hdiessner/gardenirrigation/hardware/Schematics.pdf

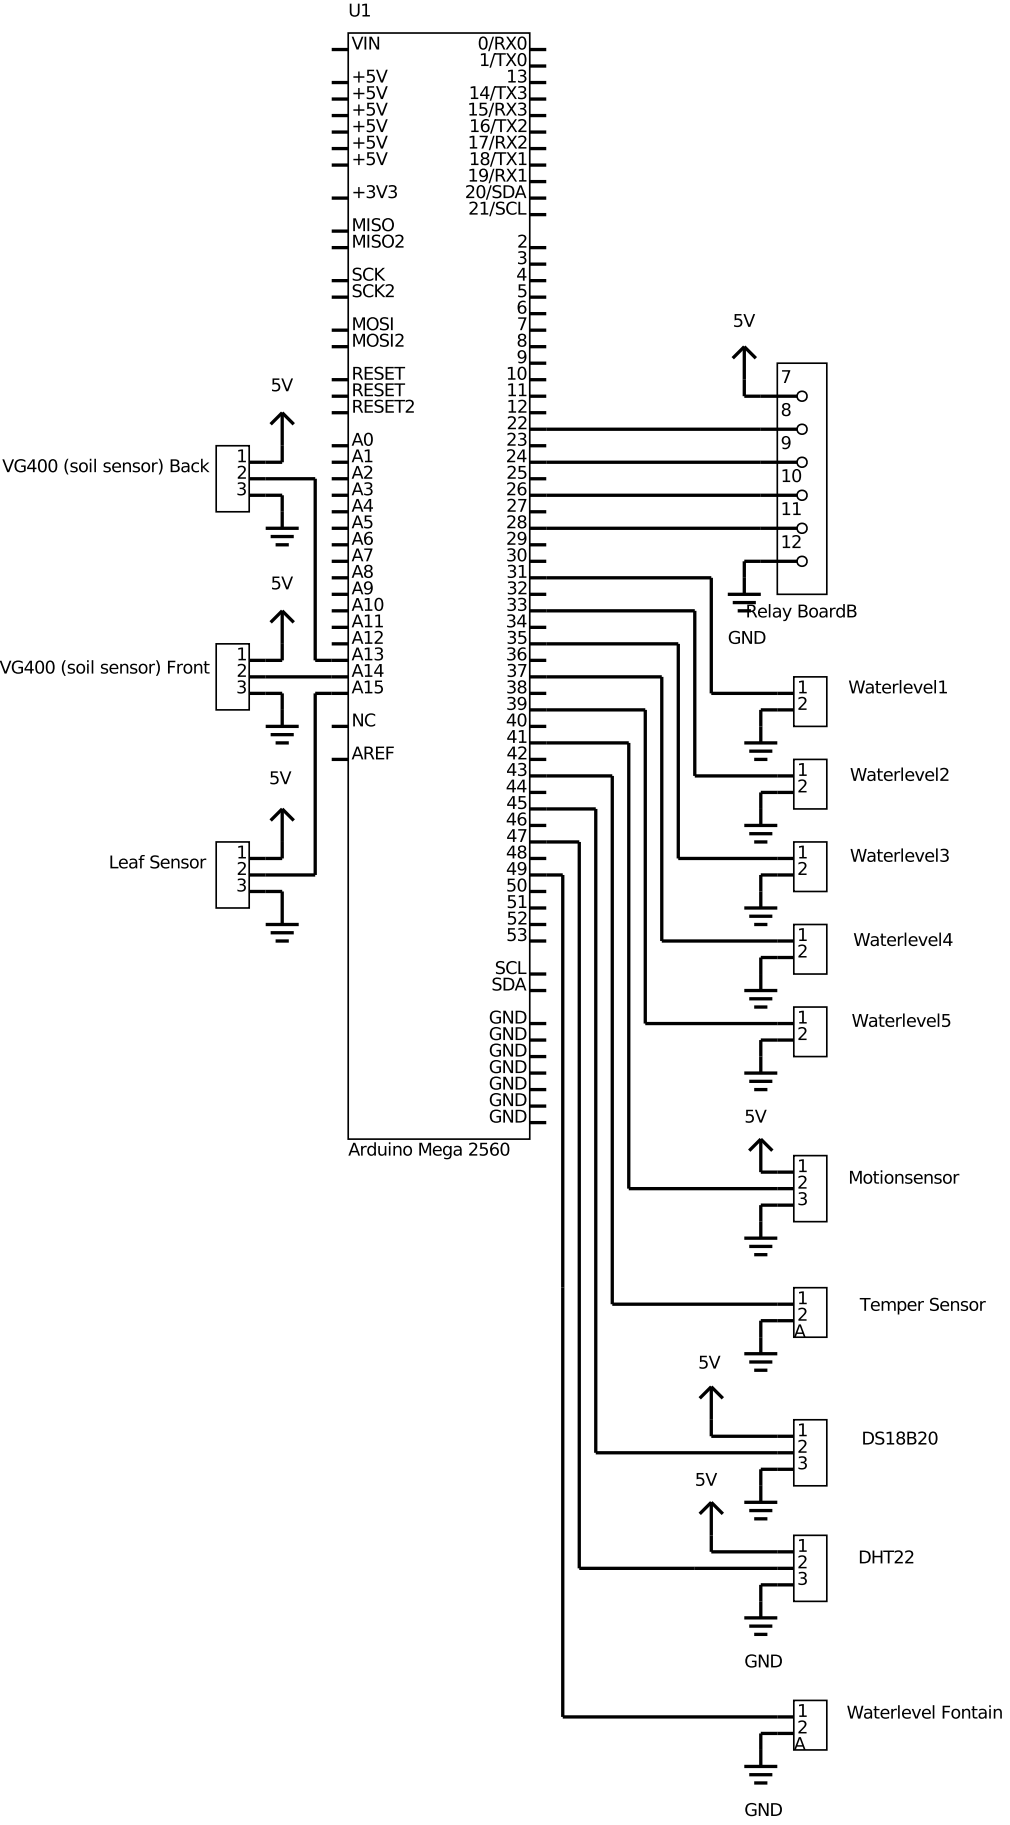
[picture p2: page 1]
