hdiessner/gardenirrigation/(commit log)

2018-06-27 Changed from arduino IDE to platoformio
2018-06-27 Adding Dallas Temperature sensor
2018-06-27 Adding Dallas temperatur sensor and clean up the code
2018-06-28 Sending now millis when motion event occures
2018-06-28 Adding schematics
2018-06-28 Schematics in documentation
2018-06-28 Added documentation for DHT wires
2018-06-30 Adding wire description
2018-06-30 Print connectors
2018-07-01 Adding waterlevel sensor for fontain
2018-07-01 Adding fontain sensor
